854259/QianRuShi/docs/esp32_p4/ESP32-P4-Function配置说明.docx

《ESP32-P4 巡检机器人开发环境配置手册》

🛠️ ESP32-P4 巡检机器人环境配置手册 (v1.0)

开发者： 金康

核心硬件： ESP32-P4-Function-EV-Board (官方开发板)

软件环境： VS Code + ESP-IDF v5.3.5

一、 软件安装与目录规范

1. SDK 与工具链安装

- 安装路径建议：
  - SDK (ESP-IDF)：建议放在 D:\ESP32（避开 C 盘空间压力）。
  - Tools (.espressif)：默认位于 C:\Espressif，包含编译器、Python 虚拟环境及 CMake。
- 版本选择：ESP32-P4 是新技术，务必使用 v5.3.5 或更高版本，否则无法识别 RISC-V 架构。

2. 路径“三大禁忌”

1. 禁中文：所有路径严禁出现中文。
2. 禁空格：文件夹名严禁带空格（如 Ken Zou 会导致 Python 脚本解析失败）。
3. 层级对齐：VS Code 必须直接打开包含 CMakeLists.txt 的子文件夹（如 hello_world），不能只打开其父目录。

二、 VS Code 插件配置

1. 核心设置

- 安装 ESP-IDF Extension 后，按 F1 搜索 Configure ESP-IDF extension。
- 配置模式：选择 ADVANCED。
- 路径校验：确保 IDF_PATH 指向 D 盘，IDF_TOOLS_PATH 指向 C 盘工具目录。

2. 项目初始化

- 创建项目：使用 ESP-IDF: New Project -> Choose Template -> get-started -> hello_world。
- Target 选择：务必点击底部蓝条，将芯片设置为 esp32p4。

三、 硬件连接与驱动安装

1. 物理接口辨析

P4 官方开发板右侧有三个 Type-C 接口：

- USB-UART (上方)：内置 CP2102N 芯片。最稳定，适合初次烧录和查看日志。
- USB-OTG (下方)：P4 原生接口。支持 USB-JTAG 高速调试，但对线材和驱动要求高。

2. 驱动安装 (CP210x)

- 现象：设备管理器中出现带黄色感叹号的 CP2102N。
- 解决：下载 Silicon Labs v11.5.0 通用驱动。
- 安装方式：解压后右键点击 silabser.inf 选择“安装”。

四、 编译、烧录与调试 (核心流)

1. 状态栏“五大金刚”

1. 插头图标：选择正确的 COM 口（如 COM9）。
2. 芯片图标：确认是 esp32p4。
3. 文件夹图标：确认当前 Workspace 路径。
4. 小火苗 (Build, Flash, Monitor)：一键编译、下载并打开监视器。
5. 小电脑 (Monitor)：仅打开串口监视器。

2. 强制烧录模式

若连接失败，执行“三部曲”：

1. 按住板载 BOOT 键。
2. 点按一下 RST 键。
3. 松开 BOOT 键（此时进入下载模式）。

五、 常见故障排除 (金康实战版)

报错信息 / 现象 | 根本原因 | 解决方案
CMakeLists.txt not found | VS Code 打开的文件夹层级不对 | 文件 -> 打开文件夹 -> 选中项目子目录
Checksum mismatch | 芯片里的程序和电脑代码不一致 | 点击“垃圾桶”图标 Full Clean，重新烧录
I2C transaction failed | 运行了 UI Demo 但没接屏幕 | 换回 hello_world 示例，或修改 SDK 配置关闭屏幕检测
Restarting in 10 seconds | Hello World 示例的正常逻辑 | 无需处理，这是代码里写的循环测试
Write timeout | 使用了纯充电线或插错接口 | 换用数据线，并将 Flash Method 选为 UART 或 JTAG

六、 队长寄语：PCB 载板设计避坑指南

1. 电源稳定性：P4 在 360MHz 运行时电流波动大，载板 3.3V 进线处必须放置 10uF + 100nF 陶瓷电容。
2. 串口保护：载板与机械臂通信的 TX/RX 线要加 100Ω 匹配电阻 和 TVS 防浪涌管。
3. USB 走线：D+/D- 必须走差分对（90Ω 阻抗），且尽量避开底部的开关电源电感，防止烧录时断连。
4. 共地原则：载板 GND 与机械臂主板 GND 必须用粗线连接，防止电位差烧毁 IO 口。
