854259/QianRuShi/docs/project/项目简介.docx

作品简介：基于 ESP32-P4 的天文台镜面自适应巡航清洁机器人

1. 项目背景与痛点 阿勒泰等高海拔天文观测站常年面临风沙侵蚀，望远镜镜面污损严重影响观测精度。传统人工清洁风险极高且周期长，极易对昂贵的光学镜面造成不可逆划伤。本项目旨在研发一款具备主动姿态补偿能力的智能巡检清洁机器人，解决极端环境下高价值光学设备柔性维护的稳定性瓶颈。

2. 系统方案与技术实现

核心控制平台： 采用乐鑫高性能双核 RISC-V 处理器 ESP32-P4，利用其 400MHz 高主频处理多维传感融合数据 。通过 MCPWM 接口驱动麦克纳姆轮，实现1kHz级高频 PID 闭环的全向运动控制 。

主动姿态补偿： 创新集成双轴自平衡载物台，利用六轴 IMU 实时解算姿态，通过高动态响应执行机构在底盘颠簸时实现瞬时水平补偿（响应时间 <30ms），确保清洁末端与镜面间的位姿恒定，防止物理碰撞。

视觉感知与交互： 利用 P4 的 MIPI-CSI 接口实现镜面污损度识别与视觉引导 。通过 Wi-Fi 6 链路对接火山引擎豆包大模型，构建基于语义理解的远程运维调度系统 。

3. 核心创新点

- 精密维护姿态解耦： 实现了移动底盘与清洁末端位姿的主动解耦，确保在斜面或非结构化地形作业时，清洁压力始终恒定且不伤及镜面。
- 具身智能运维闭环： 将边缘侧 AI 视觉检测与云端大模型决策相结合，实现了从环境风险评估到自主路径规划的无人化巡检闭环 。

4. 应用价值 作品直接针对大科学装置（如天文望远镜、光伏阵列等）的精密运维需求，显著提升了设备维护效率并降低了资产受损风险。充分展现了乐鑫 ESP32-P4 芯片在高性能电机驱动与边缘 AI 领域的应用潜力 。
