854259/QianRuShi/hardware/pcb/SCH_Schematic1_2026-05-20.pdf

# 电源电路

# 驱动电路1

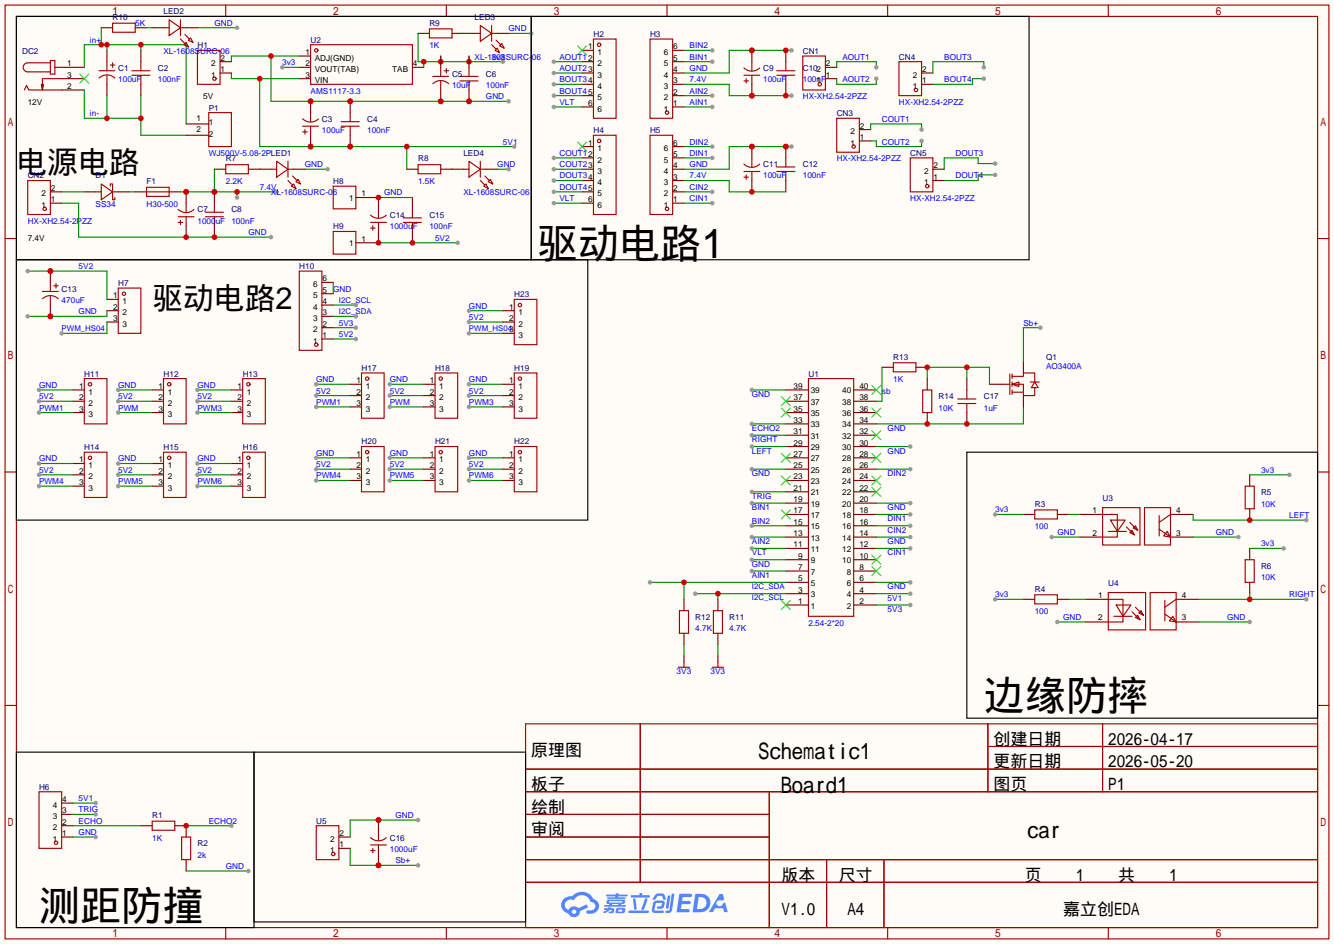
[picture p1: page 1]

原理图 | Schematic1 | 创建日期 | 2026-04-17

更新日期 | 2026-05-20

板子 | Board1 | 图页 | P1
绘制 | | car
审阅

V1.0 | A4 | 嘉立创EDA
