854259/QianRuShi/(commit log)

2026-05-22 Initial import
    [初版硬件表---机身.xlsx]
2026-05-23 Add project files
    [初版硬件表---机身.xlsx]
2026-05-23 Add integrated smart car vision robot arm system
2026-05-30 配置 Git LFS
